HayleyDeckers/Experiment-Design-2019-uu/physical_setup/OpticalElements.md

<!--- notes that might be usefule for future reproducability--->

## Optical Components

Links to the optical elements used, can find CAD pdf's there

Photodetector:
https://www.thorlabs.com/thorproduct.cfm?partnumber=PDA36A-EC

Laser mount:
https://www.thorlabs.com/thorproduct.cfm?partnumber=KM100V

Mirror mount:
https://www.thorlabs.com/thorproduct.cfm?partnumber=KM100T

Beam splitter mount:
https://www.thorlabs.com/thorproduct.cfm?partnumber=CM1-DCH

Lens mount:
https://www.thorlabs.com/newgrouppage9.cfm?objectgroup_id=1433&pn=LMR1/M#9543
