HayleyDeckers/Experiment-Design-2019-uu/lab_logs/2019-10-07.md

To be filled in.

Hardware V2:
	- Made ClipOn CAD files for LD, LS, M, L
	- Made 2 versions to see what works best when fastening to the 2020 extrusions
	- Started CAD file for all-in-1 3D-print
	- Made CAD mock-up for sample ClipOn --> need to wait to see sample before finishing this

Misc:
	- start making documentation up to date
