HayleyDeckers/Experiment-Design-2019-uu/lab_logs/2019-09-26.md

Helped G. Blab clean the ultimaker 2+. Sliced CAD files and started print. Estimated printing time 8 hours.
