HayleyDeckers/Experiment-Design-2019-uu/manual/src/optics.md

# Attaching and aligning the optics

With the base constructed, we can start attaching the optical parts. Each part should come with a bolt or bolt-hole and can be fastened into the sliders with ease. At the end of this chapter the setup should look like shown in [chapter 4](./build_start.md).
