HayleyDeckers/Experiment-Design-2019-uu/examination_material/contacts_and_value_exchange.md

## UU Contacts

Dr. G.A. Blab, Assistant professor UU
* allowed us usage of the Ultimaker 2+ 3D-printer in his lab
* instructed us how to use this 3D-printer before first usage

Drs. D. Killian, Technical Support Assistant for Teaching and Research UU
* organized 3 samples for the experiment (brass, steel and aluminium rods)
* introduced us to the laser cutter and Formlabs 3D-printer if we need it
* organized AD590 temperature sensor

R.H.S. Borkus, Research and Education Assistant
* assisted with a range of practical issues in the laboratory
* supplied optical elements used in the experiment
* supplied tools needed to construct the experiment

P. Koopman, Technical Support Assistant for Teaching and Research
* assisted in alignment of the optical elements of the experiment
* assisted in organizing the breadboard and Arduino electronics
* soldered jumper wires for AD590 temperature sensor

Dr. D.F. Bouchet, Researcher (our project mentor)
* advised in alignment of the setup
* advised in design of the setup
* advised on the data analysis of the signal

## Students

Sam
* provided coffee and tea and emotional assistance during the drinking thereof

Stan
* fun times were had trying to get Arduino to do what we want
* coffee is yummy

Amber
* re-usable coffee cup buddy

## state of value-exchange and the ideal state

Most of our value exchange with the UU-staff has been one-directional, where we receive assistance from the staff without providing a service to them. This is to be expected, but obviously not ideal. With the students we have had a more equal exchange pattern. When someone, either us to the other students or other students towards us, has a problem the experience has been that everyone will try their best to help within constraints of their knowledge and available time.
