HayleyDeckers/Experiment-Design-2019-uu/examination_material/Project Canvas.pptx

See next slide for instructions!

Notes: Go to File > Make a Copy… to make your own canvas
See next slide for instructions

## Slide 2
