HayleyDeckers/Experiment-Design-2019-uu/examination_material/ProjectContext/M_Interferometer.PNG

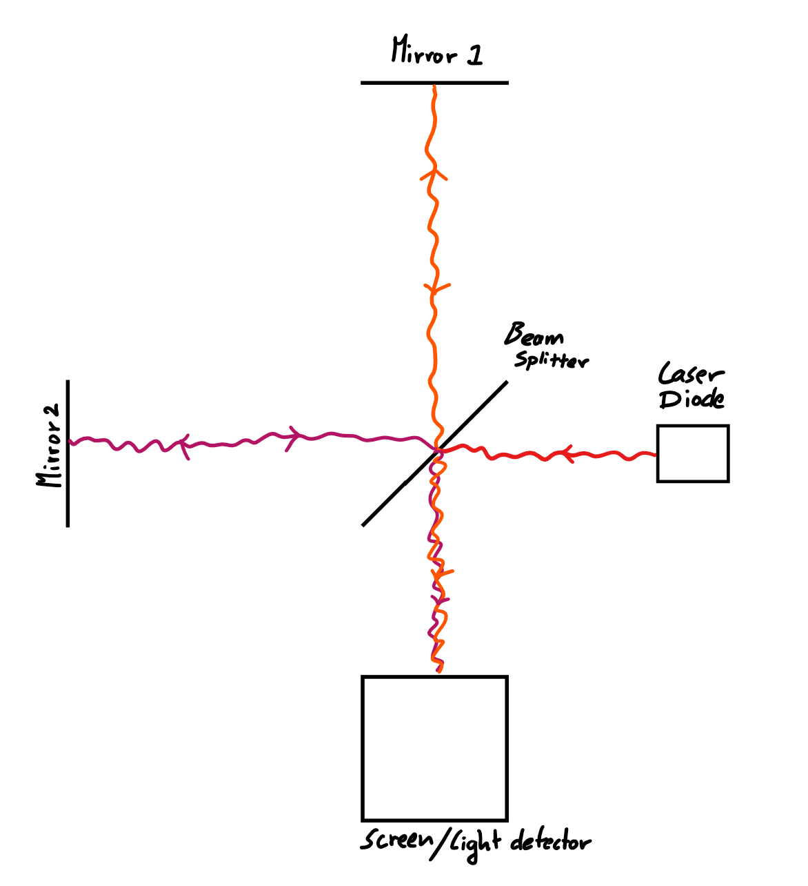
examination_material/ProjectContext/M_Interferometer.PNG
