HayleyDeckers/Experiment-Design-2019-uu/manual/images/lego_inventory2.png

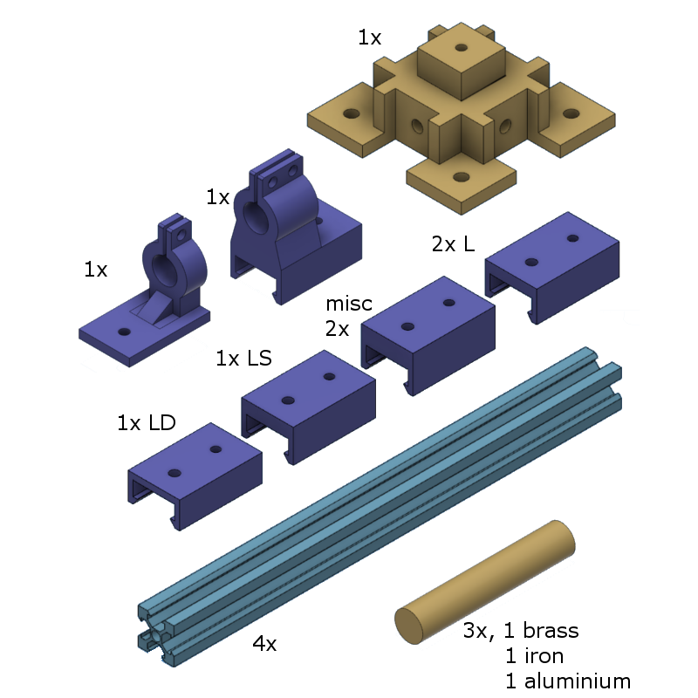
manual/images/lego_inventory2.png
