HayleyDeckers/Experiment-Design-2019-uu/physical_setup/AD590.md

Some useful links and things for the AD590 temp sensor. Our sensor was soldered with the white jumper wire being V+ and black jumper wire being V-
x data sheet
    -> https://www.analog.com/media/en/technical-documentation/data-sheets/AD590.pdf

x arduino forum discussion on using AD590
    -> https://forum.arduino.cc/index.php?topic=400506.0
    -> example code taken from there:

float tempvalue=0;
void setup() {
  // initialize serial communication at 9600 bits per second:
  Serial.begin(9600);
}

// the loop routine runs over and over again forever:
void loop() {
  // read the input on analog pin 0:

  // print out the value you read:

  int sensorValue = analogRead(A0);
  Serial.print ("Kelvin :");
  Serial.println(sensorValue);
  tempvalue=sensorValue-273.15;
  Serial.print("Celcius :");
  Serial.println(tempvalue);
  delay(1000);        // delay in between reads for stability
}
