HayleyDeckers/Experiment-Design-2019-uu/physical_setup/CAD_links.md

The links to the Fusion360 CAD files made for this experiment
Password: ExpDesignCourseUU2019

https://a360.co/2MhYaZD -- 2020 ClipOn file

https://a360.co/35esk8A -- Ensemble file

https://a360.co/2p0dphC -- Ensemble 1Block file
