HayleyDeckers/Experiment-Design-2019-uu/manual/src/CAD.md

# CAD files

The links to the Fusion360 CAD files made for this experiment

Password: ExpDesignCourseUU2019

[2020 Clip file](https://a360.co/2MhYaZD)

[Ensemble file](https://a360.co/35esk8A)

[Sample holder](https://a360.co/32A4WRa)
