HayleyDeckers/Experiment-Design-2019-uu/manual/src/SUMMARY.md

## Summary
[Foreword](./foreword.md)

[Prerequisite Knowledge](./prereq.md)

[Safety Instructions](./safety.md)

## Theory
- [What is an interferometer (and why should I care?)](./interferometer.md)
- [What is a Michelson Interferometer?](./M_Interferometer.md)
- [Measuring thermal expansion with an interferometer](./thermal_expansion.md)

## Building the Interferometer
- [Our interferometer design](./build_start.md)
- [What do you need to build our interferometer](./needed_materials.md)
  - [Printing the parts](./printing.md)
  - [Building the Base](./building_base.md)
  - [Attaching the slide-on parts](./slideons.md)
  - [Installing the sample holder](./sample.md)
- [Attaching and aligning the optics](./optics.md)
  - [Laser and opposite mirror](./laser_and_opposite_mirror.md)
  - [Adding the beam splitter](./adding_the_bs.md)
  - [Calibrating dot to dot](./calibrate_dot_to_dot.md)
  - [Expanding the beam](./expand_the_beam.md)
  - [Getting a good interference pattern](./interference_pattern.md)
  - [Attaching the gain detector](./detector.md)

## Interfacing with the arduino
- [Performing the experiment](./automation.md)
  - [Recording data](./record.md)
  - [Measuring thermal expansion](./thermal.md)
  - [Data processing](./data.md)

### Appendices with explanations of what went wrong
- [Special Thanks](./thanks.md)
- [CAD files](./CAD.md)
