HayleyDeckers/Experiment-Design-2019-uu/manual/src/prereq.md

# Prerequisite Knowledge

Using the [Arduino IDE](https://www.arduino.cc/en/Tutorial/HomePage)

Using [Python](https://wiki.python.org/moin/BeginnersGuide)

Elementary electronical circuitry building
