HayleyDeckers/Experiment-Design-2019-uu/manual/src/interferometer.md

# What is an interferometer (and why should I care?)

Interferometry is the general term for a group of experimental techniques that use the phenomenon of [interference](https://en.wikipedia.org/wiki/Wave_interference) by [superposition](https://en.wikipedia.org/wiki/Superposition_principle) to measure something. This usually means superimposing electromagnetic waves by adding up a two beams of electromagnetic waves. The simplest form of this phenomenon shown in the figure below.

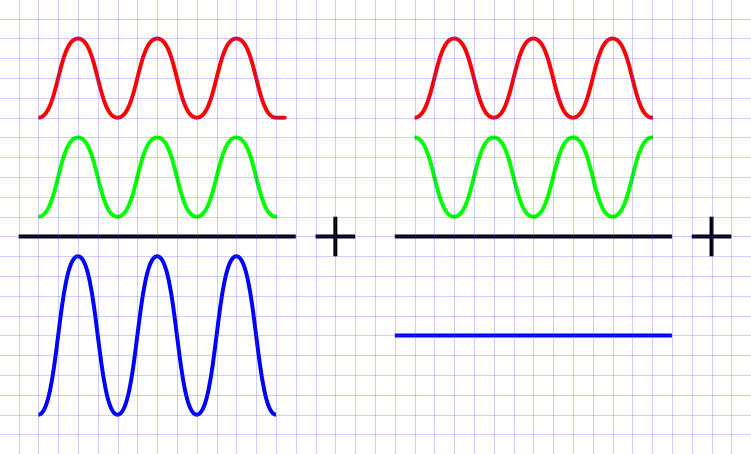
[picture p22: manual/images/superposition.png]

*Example of how superimposing two waves on eachother works.*

 Interferometers use this to make measurements of very small displacements and the displacements that can be measured are related to the wavelength of your wave source. The interference patterns give you information on pathlengths of the waves you measure. Using electromagnetic waves as source the precision can be in the order of nanometers, which makes interferometers the instruments with the highest precision in measuring lengths.

The fun thing is, some of the simplest interferometers are really easy to build by yourself at home! This allows for fun experiments you can do at home and can offer great learning experiences. One of these simple interferometers is a Michelson Interferometer, which was used in the famous [Michelson-Morley Experiment in 1887](https://en.wikipedia.org/wiki/Michelson%E2%80%93Morley_experiment).
