HayleyDeckers/Experiment-Design-2019-uu/manual/images/2020_CentreConnector.PNG

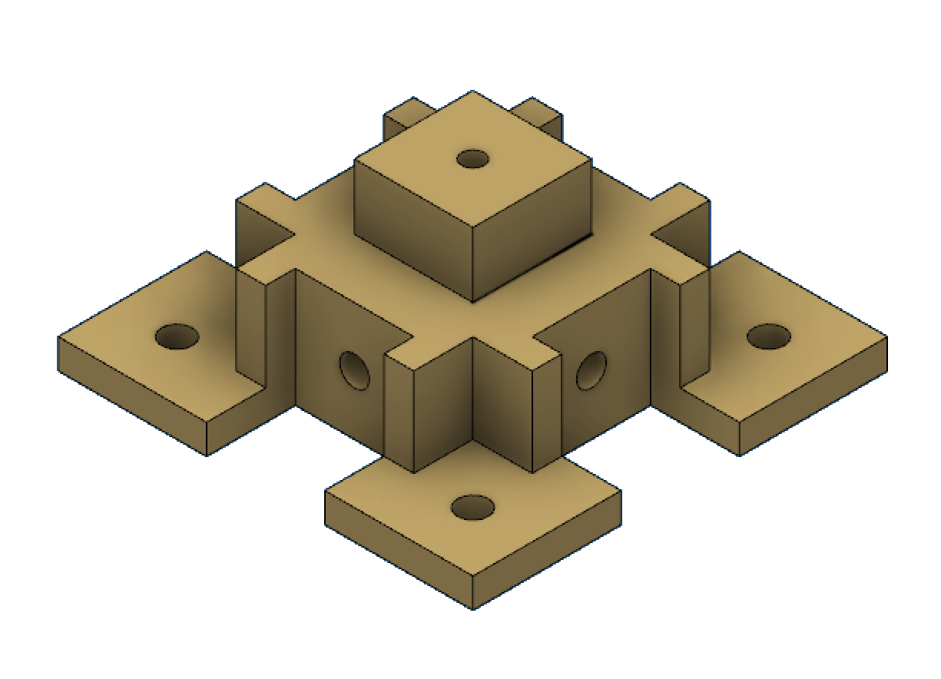
manual/images/2020_CentreConnector.PNG
