HayleyDeckers/Experiment-Design-2019-uu/manual/images/2020Clip_L_D.PNG

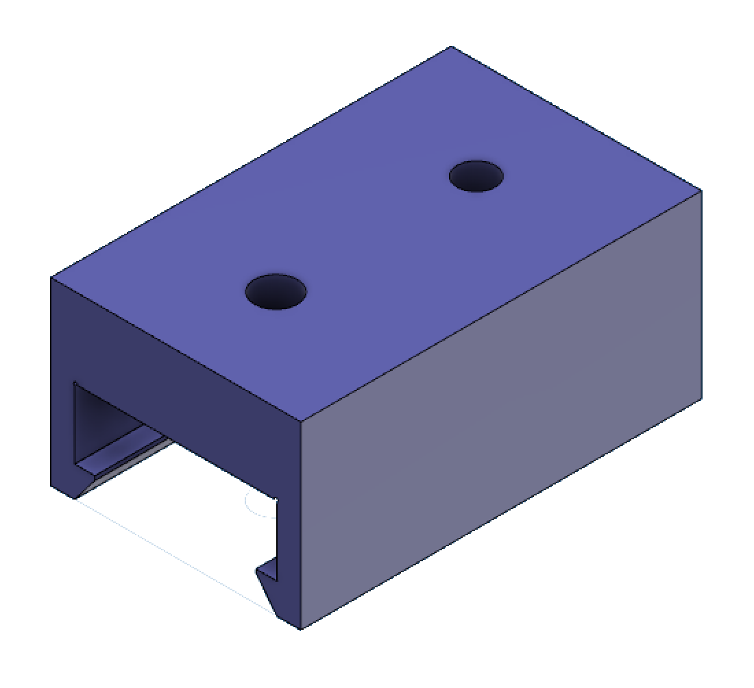
manual/images/2020Clip_L_D.PNG
