HayleyDeckers/Experiment-Design-2019-uu/manual/images/2020Clip_LS.PNG

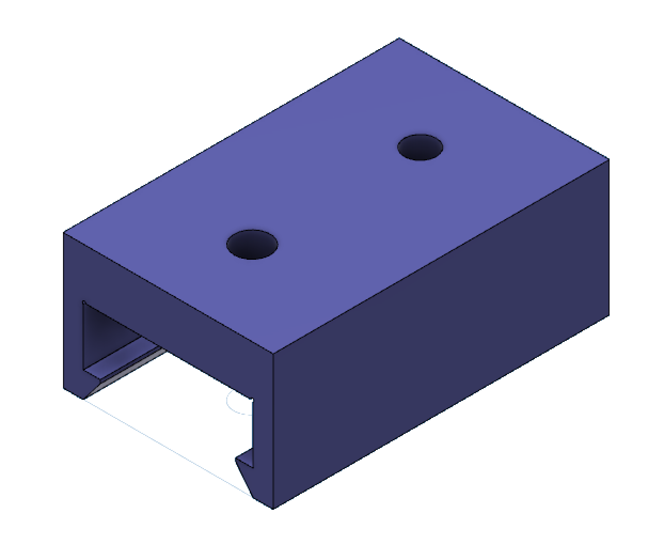
manual/images/2020Clip_LS.PNG
