HayleyDeckers/Experiment-Design-2019-uu/manual/images/2020Clips.PNG

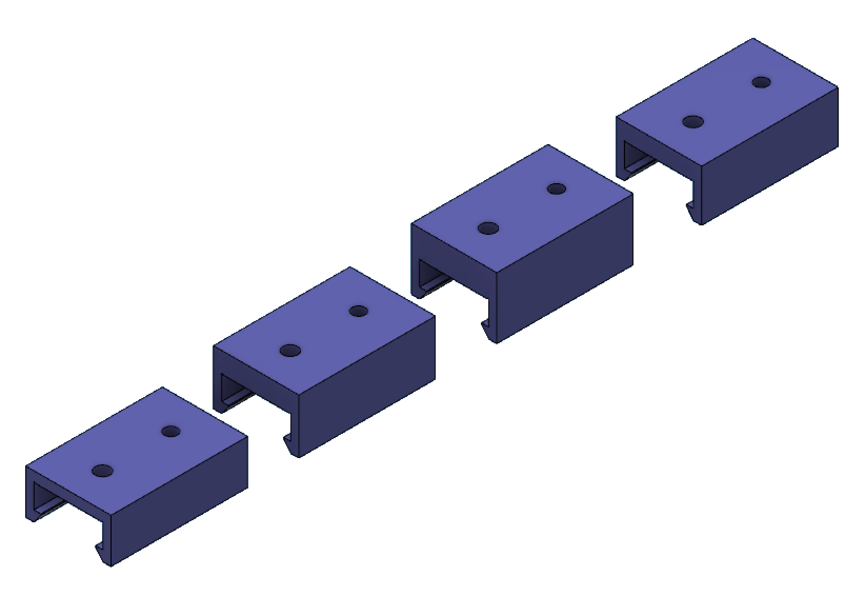
manual/images/2020Clips.PNG
