HayleyDeckers/Experiment-Design-2019-uu/manual/images/2020Vslot.PNG

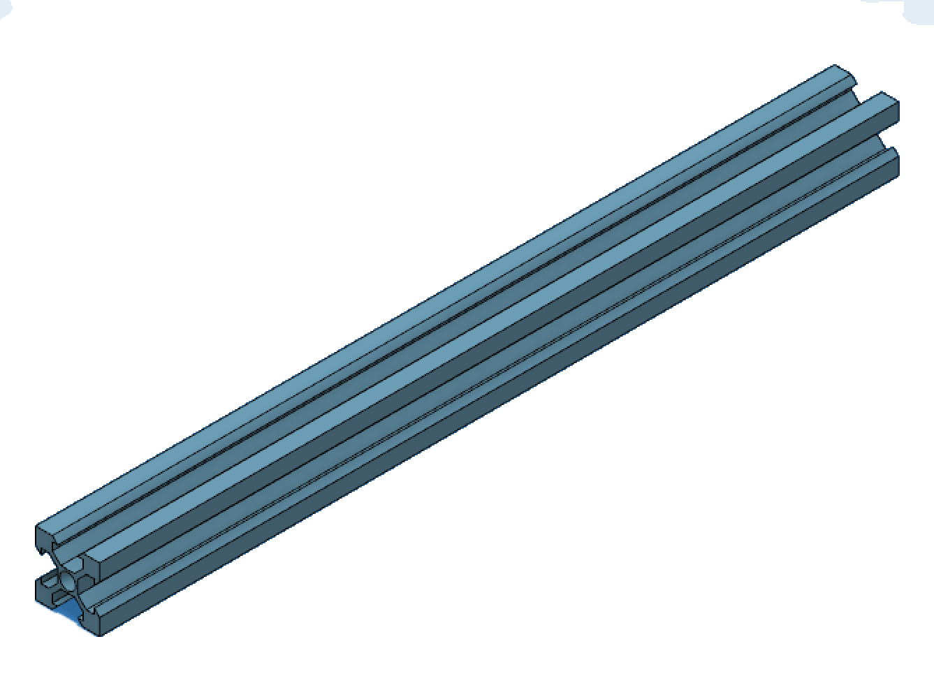
manual/images/2020Vslot.PNG
