HayleyDeckers/Experiment-Design-2019-uu/manual/images/circuitry.png

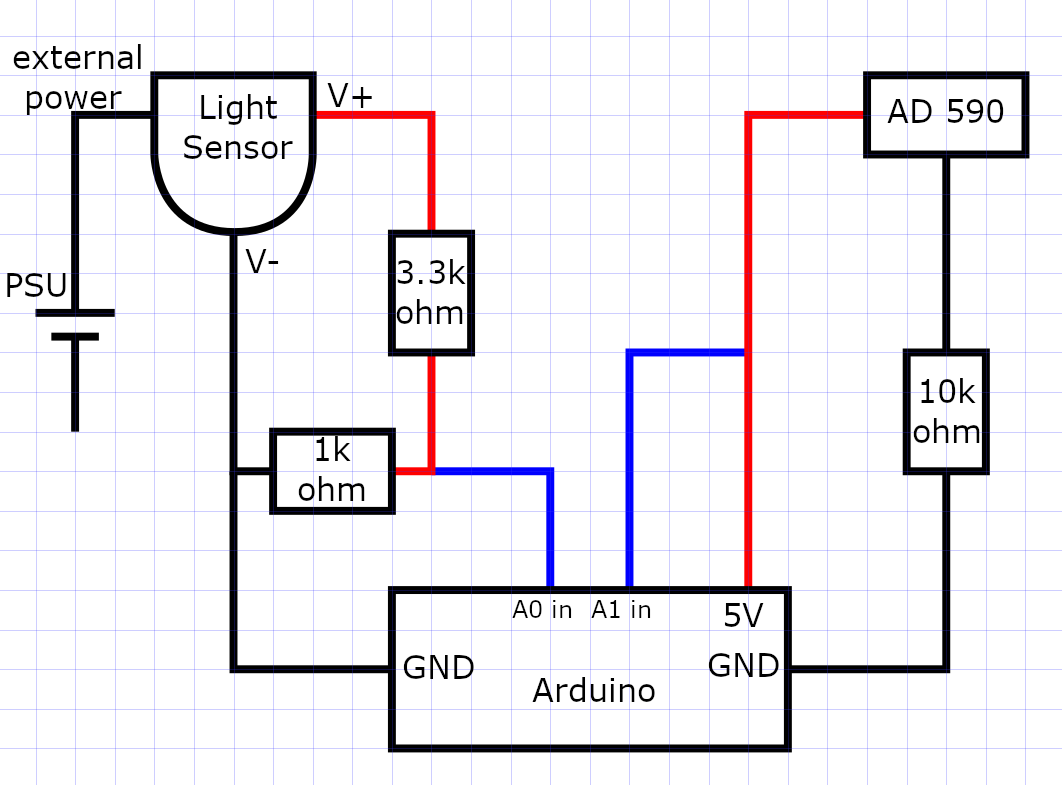
manual/images/circuitry.png
