HayleyDeckers/Experiment-Design-2019-uu/manual/images/Sample.PNG

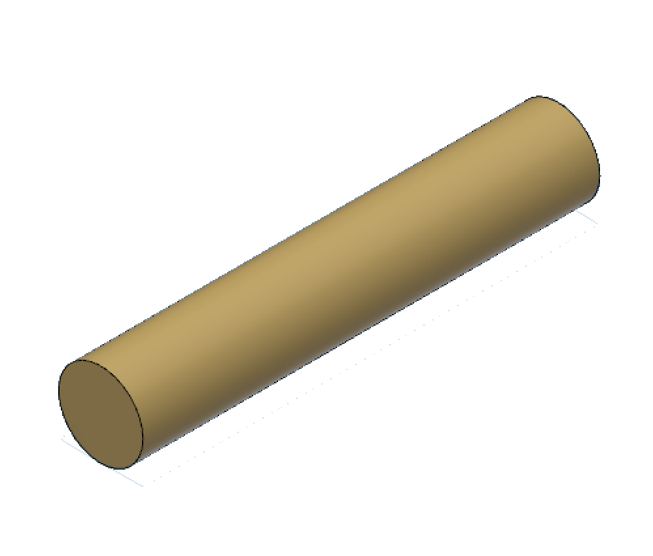
manual/images/Sample.PNG
