HayleyDeckers/Experiment-Design-2019-uu/manual/images/sample_holder1.png

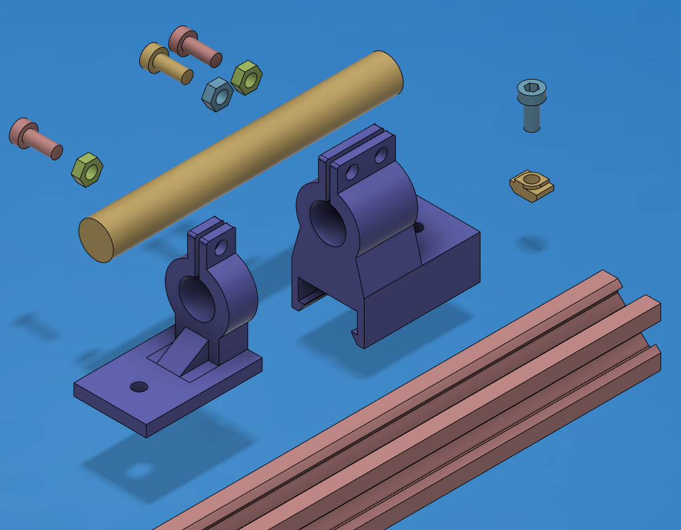
manual/images/sample_holder1.png
