HayleyDeckers/Experiment-Design-2019-uu/manual/images/sliding_nut2.png

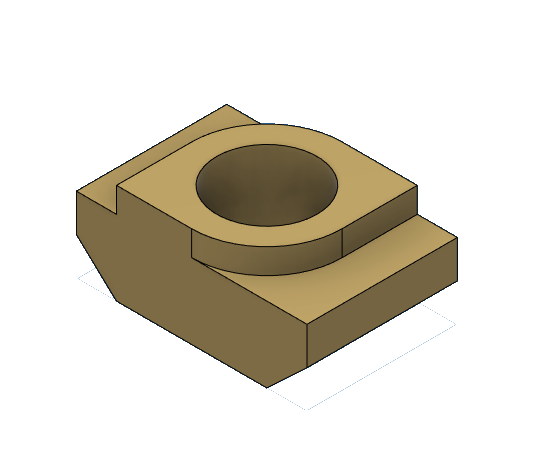
manual/images/sliding_nut2.png
