HayleyDeckers/Experiment-Design-2019-uu/physical_setup/LightSensorCircuit.png

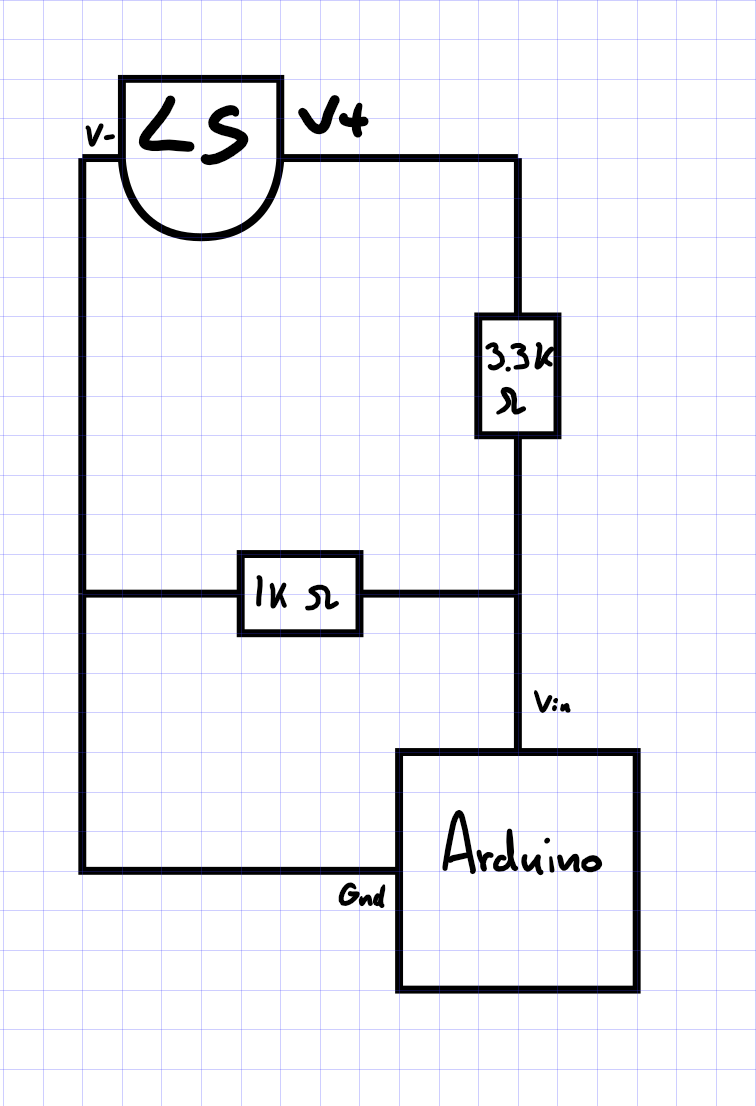
physical_setup/LightSensorCircuit.png
