HayleyDeckers/Experiment-Design-2019-uu/(threads)

Thread 2 (2019-10-07):

Debug Serial Interface

HayleyDeckers, 2019-10-07:
For some reason, sometimes the serial interface spews out some garbage ocasionaly when reading from Python. I believe to know what causes this (not waiting on the serial interface to be ready before entering the `loop` function on the arduino). Needs investigating.

HayleyDeckers, 2019-10-09:
Cleaned up interfacing code and verified that the Serial connection behaves as expected in 432b7a65a8045d73514e2a148192d4561ec05b7e , however we're still seeing some non-sensical data occasionaly, such as the read-out suddenly dropping in half or not going to zero when the sensor is completely occluded.

HayleyDeckers, 2019-10-10:
Problem was caused by the python rendering being too slow and not being able to keep up (With a serial interface!!!). Fixed now

Thread 3 (2019-10-07):

Design and print a sample holder

HayleyDeckers, 2019-10-07:
We need to design and print a sample holder, that is, something to attach our heated element to such that we can measure it's thermal expansion.

KiraMaathuis, 2019-10-09:
Design V0: 2 parts, 1 part printed well, 1 did not. Just started V1 print, Estimated to take 2 hours (done 17:20)

HayleyDeckers, 2019-10-10:
Sample holder works. Slightly noisy, see #17, but the design seems fine.

Closed 2019-10-10.

Thread 4 (2019-10-07):

Add supports to the frame

HayleyDeckers, 2019-10-07:
Add little feetsies to the frame, such that it is more stable/shock resistant, and less likely to slip when the interferometer is being aligned.

HayleyDeckers, 2019-10-07:
@KiraMaathuis You had some latex paint right? could we pour that into a mold and cure it?

Thread 7 (2019-10-07):

Add thermocouple to the arduino.

HayleyDeckers, 2019-10-07:
Interface the arduino with the temperature measurement device.
Depends upon #6 and #3 .

KiraMaathuis, 2019-10-10:
Soldered the AD590 temperature sensor to a set of jumper wires. White wire is V+,  black wire is V-. Added an AD590.md file with a link to the datasheet, an Arduino forum discussion on how to use it with Arduino and some sample code.

Physical AD590 part and circuit is done, needs to be integrated into the Arduino code to work.

HayleyDeckers, 2019-10-13:
Thermocouple works and can be read.

Closed 2019-10-13.

Thread 16 (2019-10-10):

Python plotting can't keep up with real-time data collection

HayleyDeckers, 2019-10-10:
As noted in #2. Should rework the plotting framework.

Thread 17 (2019-10-10):

Sample is extremely sensitive to vibrations

HayleyDeckers, 2019-10-10:
The sample (brass) is extremely sensitive to vibrations, clearly picking up sound waves. Investigating smaller samples and steel instead of brass.
