HayleyDeckers/Experiment-Design-2019-uu/(commit log)

2019-10-07 added optical parts CAD file links
2019-10-09 Improved arduino-python interface
2019-10-09 Improved arduino-python interface, added batch mode support
2019-10-10 Added an AD590 and CAD info file
2019-10-11 bugfixes, display data in batch mode
    [analogRead.py]
2019-10-11 Updated some examinations materials
2019-10-13 bugfix, accidentally remvoed handshake
    [AnalogReadSerial.ino]
2019-10-13 Arduino now reads thermocouple, optical sensor, and timestamp
2019-10-14 minor correction, moved the second read after the milis call.
    [AnalogReadSerial.ino]
2019-10-14 To do list for tomorrow, made a circuit diagram for light sensor.
2019-10-20 start on needed materials
2019-10-21 only use lower-case extensions
2019-10-21 name the sensor
2019-10-21 warn that sensor is polarized
2019-10-30 Added our 1 minute pitch script
